viljamip/Voron_mods/V2.4 Kinematic bed mount/README.md

# V2.4 Kinematic bed mount

## Images
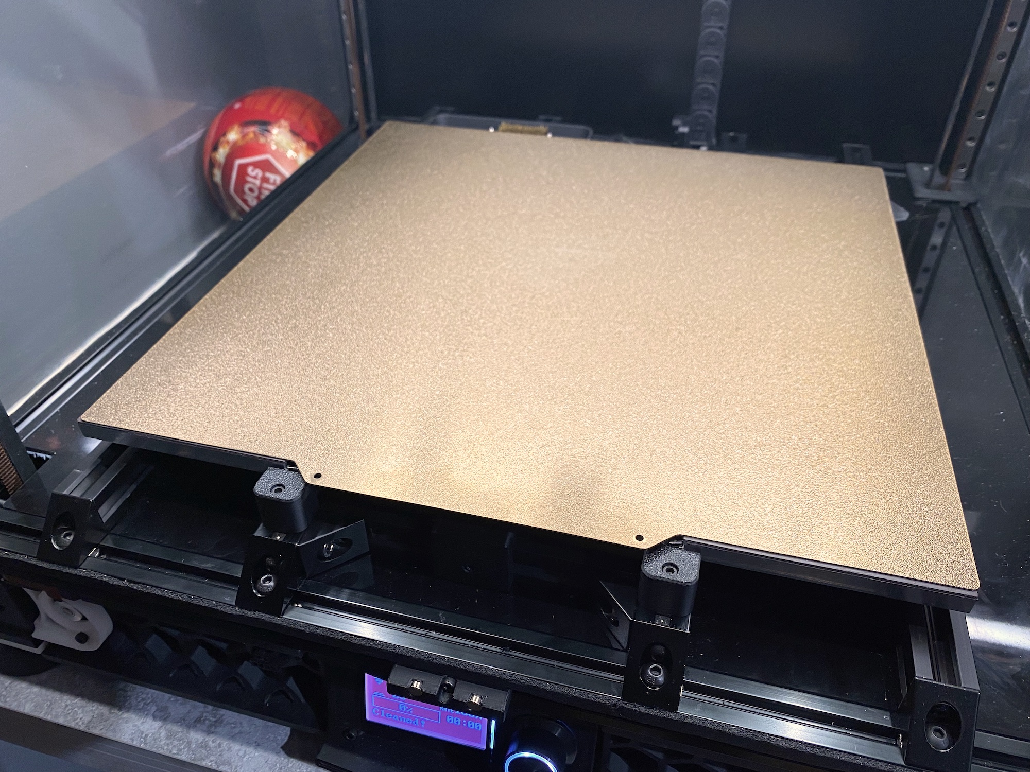
[picture p1: V2.4 Kinematic bed mount/Images/Kinematic_mount_3.jpg]
Mod installed to my V2.4

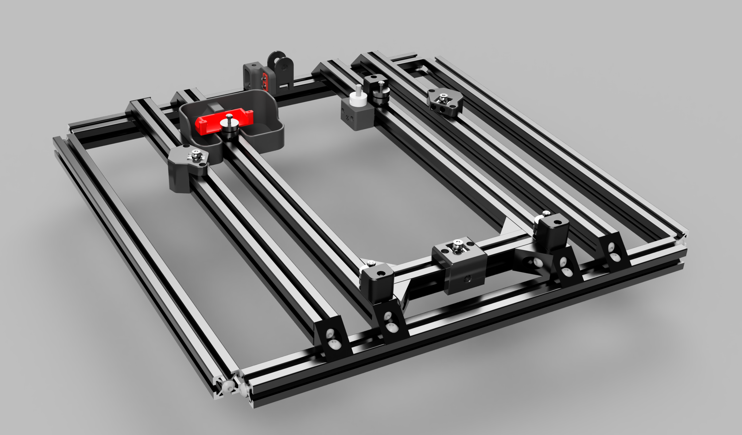
[picture p2: V2.4 Kinematic bed mount/Images/Kinematic_mount_1.png]
CAD image without bed

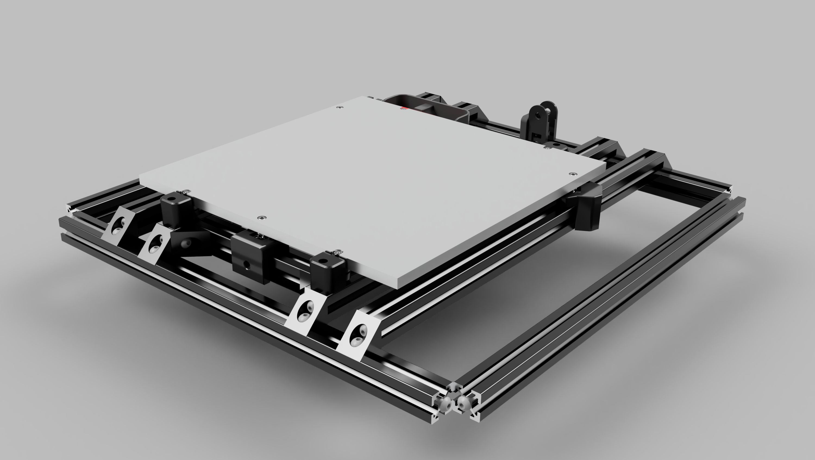
[picture p3: V2.4 Kinematic bed mount/Images/Kinematic_mount_2.png]
CAD image with bed


## BOM
| Count | Item | Comments | Links |
|---|---|---|---|
| 6 | Hardened pin 5x20 mm | Hard pins should theoretically perform better than soft ones. | [Aliexpress](https://www.aliexpress.com/item/32840748469.html) |
| 3 | 8 or 9 mm M3 threaded steel ball | I used the 8 mm stainless ones as they are sold for this application. | [Hightemp3d](https://www.hightemp3d.eu/products/polished-8-mm-steel-ball-with-m3-thread-3d-printer) [Aliexpress](https://www.aliexpress.com/item/33014236308.html) |
| 3 | M3 PEEK washer | Normal washers will probably work too, but they will transfer more heat to the pins. | [Aliexpress](https://www.aliexpress.com/item/32970590570.html) |
| 4 | 16x4.5 mm SmCo POT magnet | I have yet to find a good global source for these as most vendors do not mention the polarity.</br>Needs to be temperature resistant to at least 150°C.</br>Needs to have polarity opposite to the other magnets. | [Componet (Finland)](https://www.componet.fi/pot-magneetit/samarium-koboltti-pot-magneetit-smco/reiaelliset-pot-magneetit-smco-350c/1273-reiaellinen-pot-magneetti-16x45mm-smco-350c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) |
| 4 | 16x5 mm Neodynium POT magnet | I have yet to find a good global source for these as most vendors do not mention the polarity.</br>Needs to have polarity opposite to the other magnets. | [Componet (Finland)](https://www.componet.fi/pot-magneetit/reialliset-pot-magneetit/pot-magneetti-uppokantaruuville/158-uppokantareikainen-pot-magneetti-16x45mm) |
| 16 | M3x8 SHCS | Used for the balls, pin mounts and bed magnets | |
| 4 | M3 nut | I used M3 square nuts but any kind should work. | |
| 4 | M3x12 Flat head screw | SHCS if you magnets have a cylindrical mounting hole instead of a countersink | |
| 12 | M4 washer | Used for spacing the frame magnets close to the bed magnets | |
| 1 | Longer Z endstop pin | The bed is a few millimeter higher than stock so you probably have to make a new Z endstop pin. | |
| 1 | 130mm 2020 extrusion | I used Vslot as it is easier to get. | [Aliexpress](https://www.aliexpress.com/item/1005001302048388.html) |
| 2 | Bed size + 120mm long 2020 extrusion | Same length as stock bed mounting extrusions. I used Vslot as it is easier to get. | [Aliexpress](https://www.aliexpress.com/item/1005001302048388.html) |
| 8 | OpenBuilds Angle Corner Connector | Same as used for mounting the stock bed extrusions. | [Aliexpress](https://www.aliexpress.com/item/1005001882900721.html) |
| 4 | M5x16 BHCS | Same as used for mounting the stock bed extrusions. | [Aliexpress](https://www.aliexpress.com/item/10000148429238.html) |
| 12 | M5x10 BHCS | Same as used for mounting the stock bed extrusions. | [Aliexpress](https://www.aliexpress.com/item/10000148429238.html) |
| 12 | M5 1mm spacer | Same as used for mounting the stock bed extrusions. | [Aliexpress](https://www.aliexpress.com/item/32917948919.html) |

## Test results
I used whoppingpochard's [measure_thermal_behavior.py](https://github.com/tanaes/measure_thermal_behavior) script to measure performance with the stock bed mounting and this mod. I also installed extrusion backers together with this mod but it should not affect significantly the plots shown below.
### Before
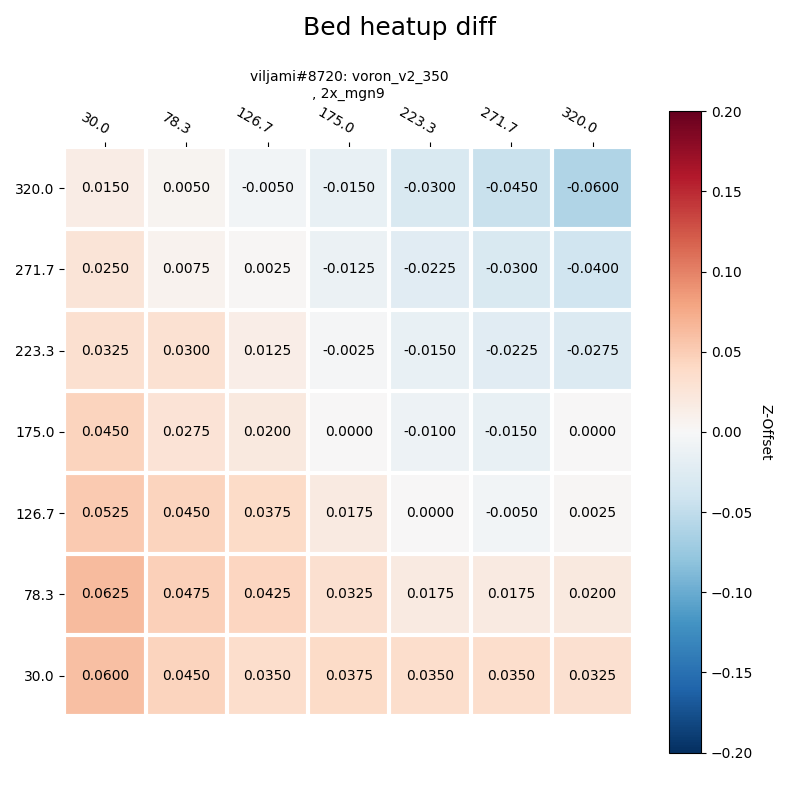
[picture p4: V2.4 Kinematic bed mount/Images/before.png]

### After
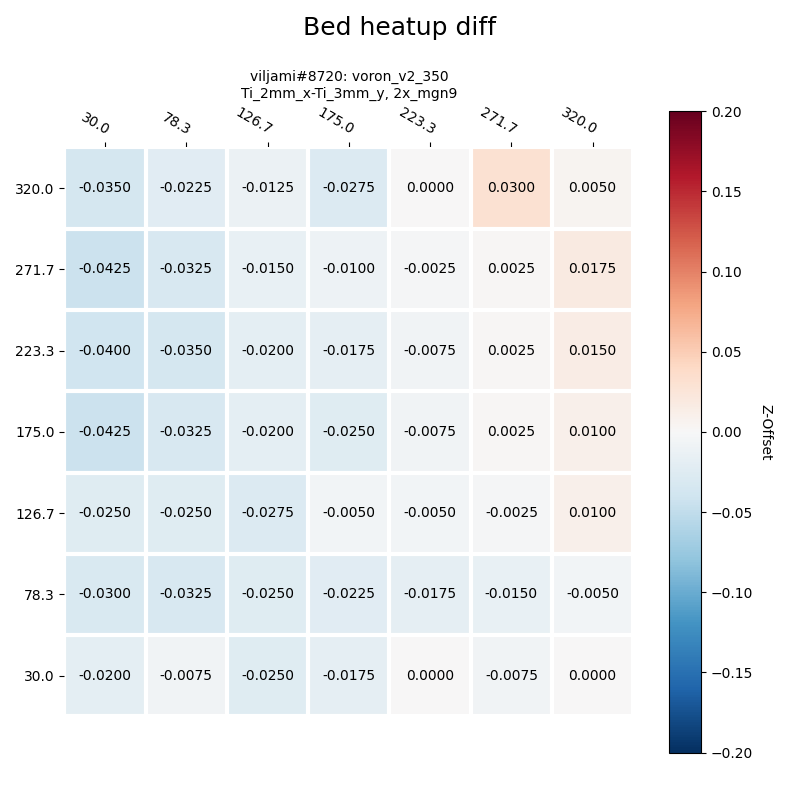
[picture p5: V2.4 Kinematic bed mount/Images/after.png]

After
