viljamip/Voron_mods/V2.4 Kinematic bed mount/STLs/Decontaminator_Purge_Bucket_&_Nozzle_Scrubber/brush_holder_spacer_3.5mm_x1.stl

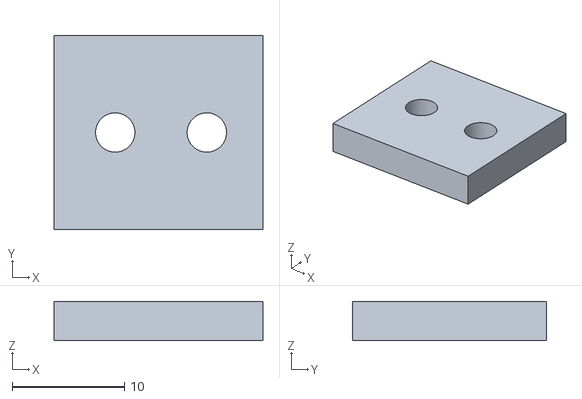
[picture p6: CAD file, 2021-10-24]
V2.4 Kinematic bed mount/STLs/Decontaminator_Purge_Bucket_&_Nozzle_Scrubber/brush_holder_spacer_3.5mm_x1.stl
18.6 x 17.3 x 3.50
