viljamip/Voron_mods/V2.4 Kinematic bed mount/STLs/rear_right_kinematic_mount_x1.stl

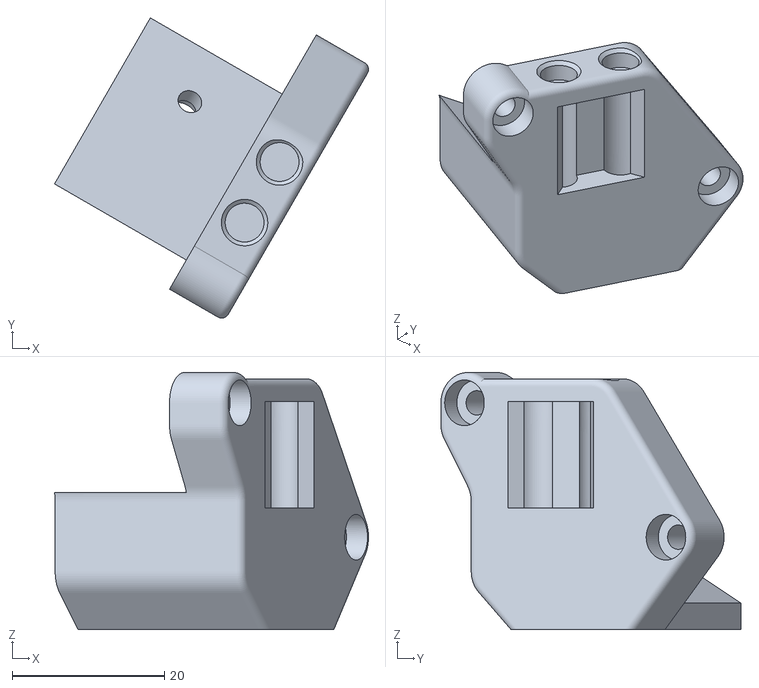
[picture p7: CAD file, 2021-10-24]
V2.4 Kinematic bed mount/STLs/rear_right_kinematic_mount_x1.stl
41.2 x 39.4 x 33.8
