viljamip/Voron_mods/V2.4 Kinematic bed mount/STLs/Decontaminator_Purge_Bucket_&_Nozzle_Scrubber/brush_holder_x1.stl

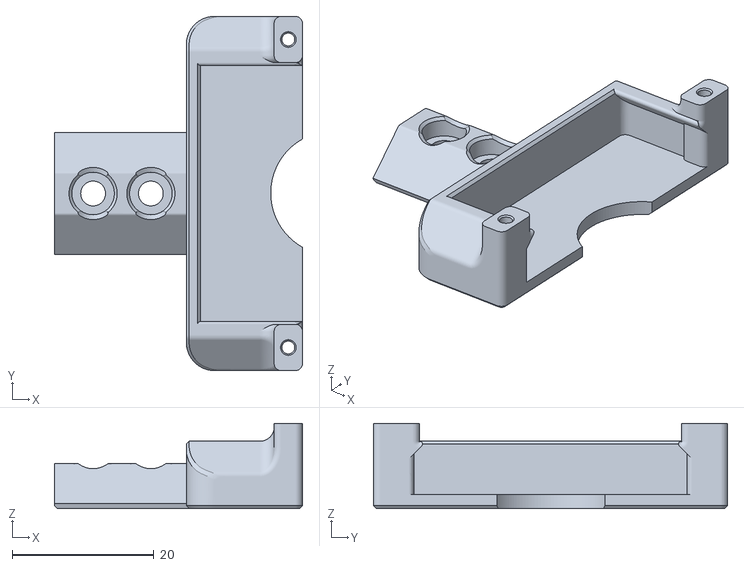
[picture p8: CAD file, 2021-10-24]
V2.4 Kinematic bed mount/STLs/Decontaminator_Purge_Bucket_&_Nozzle_Scrubber/brush_holder_x1.stl
35.0 x 50.0 x 12.0
