viljamip/Voron_mods/V2.4 Kinematic bed mount/STLs/front_kinematic_mount_x1.stl

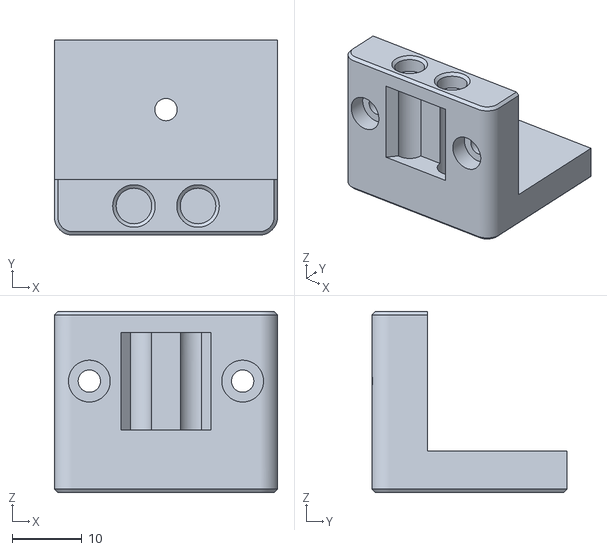
[picture p9: CAD file, 2021-10-24]
V2.4 Kinematic bed mount/STLs/front_kinematic_mount_x1.stl
32.0 x 28.0 x 26.0
