viljamip/Voron_mods/V2.4 Kinematic bed mount/STLs/Decontaminator_Purge_Bucket_&_Nozzle_Scrubber/purge_bucket_250mm_x1.stl

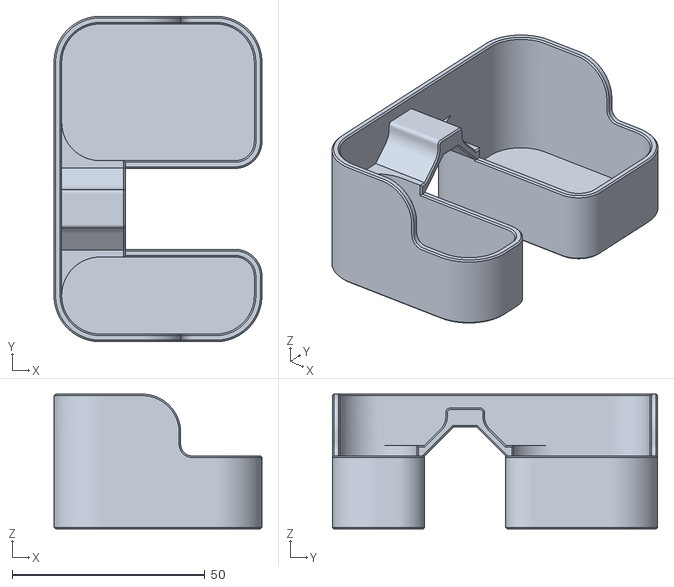
[picture p10: CAD file, 2021-10-24]
V2.4 Kinematic bed mount/STLs/Decontaminator_Purge_Bucket_&_Nozzle_Scrubber/purge_bucket_250mm_x1.stl
54.0 x 84.5 x 35.0
