viljamip/Voron_mods/V2.4 Kinematic bed mount/STLs/rear_left_kinematic_mount_x1.stl

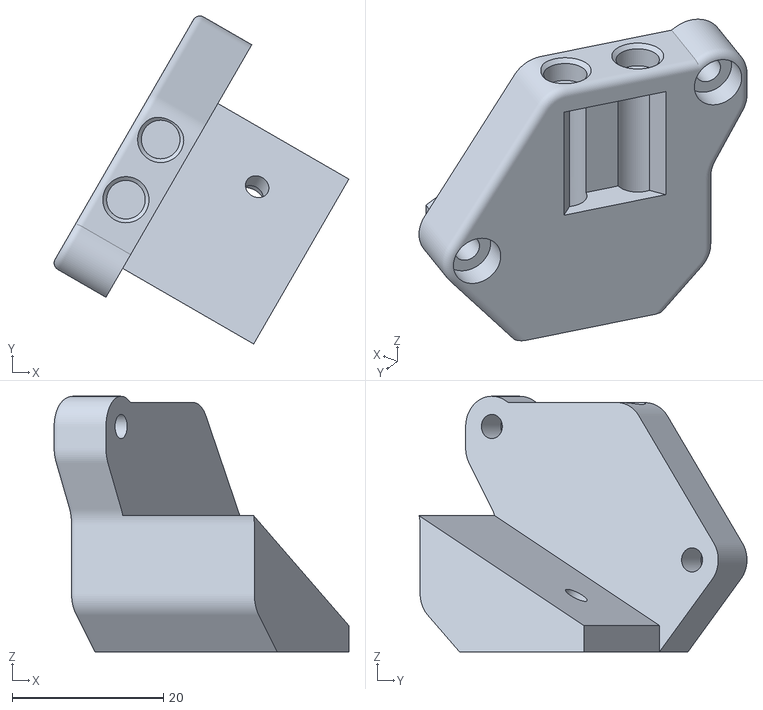
[picture p11: CAD file, 2021-10-24]
V2.4 Kinematic bed mount/STLs/rear_left_kinematic_mount_x1.stl
39.0 x 43.4 x 33.8
