viljamip/Voron_mods/V2.4 Kinematic bed mount/STLs/bed_retainer_x4.stl

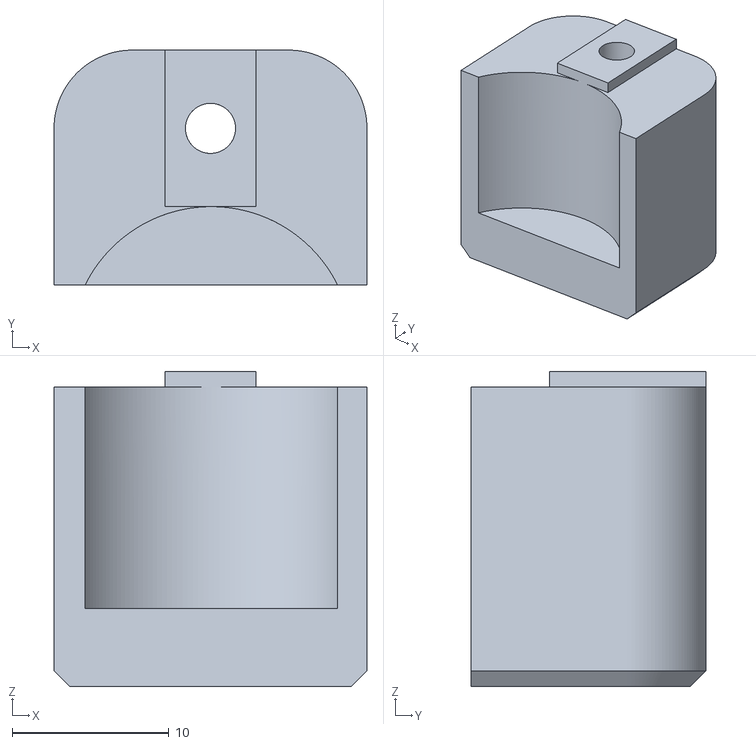
[picture p12: CAD file, 2021-10-24]
V2.4 Kinematic bed mount/STLs/bed_retainer_x4.stl
20.0 x 15.0 x 20.1
